Lebron1897/Air_Conditioner_TFG/(list of files, drawings)

Other design files:
Design_PCB/PCB_IR/PCB_IR.pcb
Design_PCB/PCB_IR/~PCB_IR.pcb
Design_PCB/PCB_PROX/PCB_PROX.pcb
Design_PCB/PCB_TEMP_HUM/Design_TEMP_PROX.pcb
Design_PCB/PCB_TEMP_HUM/~Design_TEMP_PROX.pcb
Design_PCB/PCB_TEMP_HUM/~PCB_TEMP_PROX.pcb
