Lebron1897/Air_Conditioner_TFG/Code_Func_Mod_ESP32/code_IR/Code_Remotes.h

//PANASONIC MODO:AUTO FAN:AUTO
//Protocolo de envio de los mensajes de PANASONIC_AC
//#define PAN_TEMP_16 0x0220E004000000060220E00400092080AF00000EE00000890000D5 //(216 Bits) 
uint8_t PAN_TEMP_16[27] = {0x02, 0x20, 0xE0, 0x04, 0x00, 0x00, 0x00, 0x06, 0x02, 0x20, 0xE0, 0x04, 0x00, 0x09, 0x20, 0x80, 0xAF, 0x00, 0x00, 0x0E, 0xE0, 0x00, 0x00, 0x89, 0x00, 0x00, 0xD5};
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

//Mesg Desc.: Model: 6 (RKR), Power: On, Mode: 0 (Auto), Temp: 30C, Fan: 7 (Auto), Swing(V): 15 (Auto), Swing(H): 0 (UNKNOWN), Quiet: Off, Powerful: Off, Clock: 00:00, On Timer: Off, Off Timer: Off
//Para hacer un apagado se cambia cualquier comando por la resta de un valor: 0x000000000000000000000000000100000000000000000000000001 //(216 Bits)
//#define PAN_PARA_APAGADO 0x0220E004000000060220E00400082C80AF00000EE00000890000E0 //(216 Bits)  
uint8_t PAN_PARA_APAGADO[27] = {0x02, 0x20, 0xE0, 0x04, 0x00, 0x00, 0x00, 0x06, 0x02, 0x20, 0xE0, 0x04, 0x00, 0x08, 0x2C, 0x80, 0xAF, 0x00, 0x00, 0x0E, 0xE0, 0x00, 0x00, 0x89, 0x00, 0x00, 0xE0};
uint16_t raw_PAN_PARA_APAGADO[439] = {3528, 1722,  492, 374,  444, 1288,  444, 422,  444, 422,  444, 398,  468, 422,  494, 372,  494, 372,  444, 422,  442, 422,  472, 422,  442, 424,  442, 424,  442, 1290,  444, 422,  444, 422,  494, 370,  444, 422,  442, 424,  444, 422,  442, 422,  444, 1288,  494, 1238,  444, 1288,  494, 372,  520, 372,  442, 1290,  444, 422,  492, 372,  444, 422,  492, 374,  492, 374,  444, 422,  442, 424,  444, 422,  444, 422,  444, 396,  470, 398,  466, 422,  444, 422,  518, 374,  442, 422,  442, 422,  492, 374,  442, 422,  442, 424,  442, 422,  444, 422,  444, 422,  444, 422,  444, 422,  444, 422,  444, 422,  442, 424,  520, 350,  466, 422,  444, 422,  442, 1290,  442, 1288,  444, 422,  442, 424,  442, 424,  442, 422,  442, 424,  492, 9910,  3602, 1644,  442, 424,  442, 1290,  518, 350,  466, 422,  444, 424,  442, 422,  444, 424,  442, 422,  444, 420,  494, 348,  466, 422,  442, 422,  444, 422,  442, 1292,  442, 422,  444, 398,  492, 422,  494, 372,  444, 422,  444, 422,  494, 374,  442, 1290,  440, 1290,  444, 1288,  442, 424,  494, 372,  444, 1288,  444, 422,  442, 424,  442, 398,  466, 398,  468, 426,  464, 424,  444, 422,  442, 424,  442, 424,  492, 372,  444, 422,  444, 422,  442, 422,  494, 348,  468, 422,  494, 372,  492, 1240,  444, 420,  442, 424,  470, 422,  492, 374,  444, 396,  468, 422,  442, 424,  442, 424,  442, 1288,  444, 1288,  444, 422,  444, 422,  492, 374,  492, 372,  442, 424,  492, 372,  494, 374,  470, 422,  446, 422,  442, 1290,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

//Para el funcionamiento de los sistemas de Fujitsu, hay que realizar 
//primero un apagado del sistema y posteriormente un encendido del sistema 
//en la temperatura que deseemos que se encuentre
