Lebron1897/Air_Conditioner_TFG/Code_Func_Mod_ESP32/code_IR/code_IR.ino

#include "Metodos.h"

void setup() {
  Serial.begin(115200);
  
  setup_wifi();
  setup_cliente();
  setup_esp_now();
  Actualiza_Fecha_Hora();
}

void loop() {
  Comprueba_Timer();
  Comprueba_Fecha();
  Actualiza_Cliente_loop();
}
