Lebron1897/Air_Conditioner_TFG/(commit log)

2022-08-13 Final version of PCBs
    The final version of the PCBs
    [Design_TEMP_PROX.pcb, PCB_IR.pcb, PCB_IR.sch, PCB_PROX.pcb, PCB_PROX.sch, PCB_TEMP_HUM.sch, ~Design_TEMP_PROX.pcb, ~PCB_IR.pcb]
2022-08-24 Correction errors
    Update fecha_actual at the beginning of test time and update the number of the model of the air coniditioner
    [Metodos.cpp]
2022-08-30 Correction Errors
    Error during execution with the first execution of the form progamable
    [Metodos.cpp]
2022-10-20 Upload de review
